tedtoal/SmartVent_Thermostat/README.md

# SmartVent_Thermostat

SmartVent custom thermostat project files

This project is described on hackster.io:

https://www.hackster.io/ted-toal/build-a-beutler-smartvent-custom-thermostat-6fa595
