tedtoal/SmartVent_Thermostat/documents/AZ-Touch_MKR_Rev_B.pdf

# AZ-Touch MKR (mk II)

Top wall enclosure with touchscreen for Arduino MKR & Nano

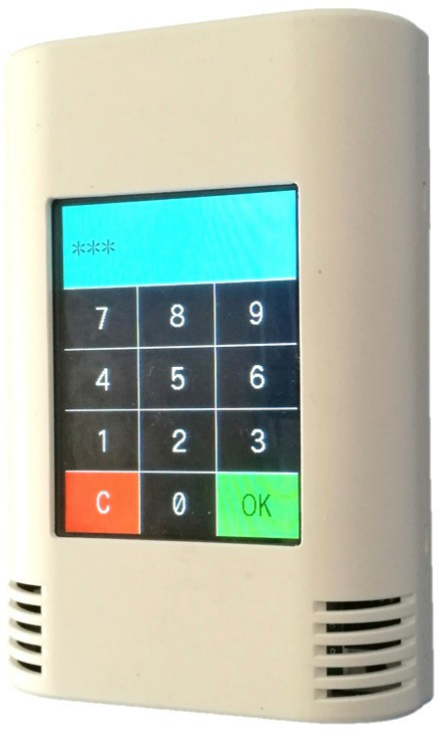
[picture p1: figure]
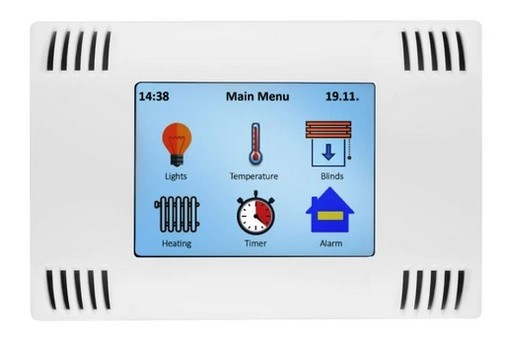
[picture p2: figure]

Features enlosure and pcb:

- top wall mounting enclosure
- 2.8 inch (7,10cm) tft screen with 320 x 240 pixel resolution
- SPI display controller ILI9341
- Resitive touch with SPI touch controller XPT2046
- Integrated 5V/1.7A voltage regulator (Vin 9...35V DC)
- Integrated prototyping area
- 4-pin removable terminal block for prototyping area & power supply
- Marked and connected GPIO & power pins beside the proto area
- Integrated piezo beeper
- Plug-in positions for Arduino MKR or Arduino Nano 33 / BLE / RP2040 boards
- Plug-in position for optional Arduino MKR shield
- Vented cover to allow through air flow
Datasheet AT-Touch MKR Rev B | Page 1 of 5 | 10/2021

Features voltage regulator:

- | Input voltage: | 15 – 30V DC
- Output voltage: 5V / 1.4A DC

Enclosure:
- Outside dimensions: 120mm x 80mm x 35mm (W x H x D)
- | Breadboard area: | 43mm x 39mm (W x H)
- | Material: | ABS
- | Finish top shell: | white
- | Finish bottom shell: | white
Datasheet AZ-Touch MKR Rev B | Page 2 of 5 | 10/2021

Top wall enclosure with touchscreen for Arduino MKR & Nano

Applications :
- Home automation
- Door access and door control
- HVAC applications
- Internet of Things (IoT)
- Intelligent wireless light switch
- Monitoring of sensor data
- Metering
- Intruder alarm systems

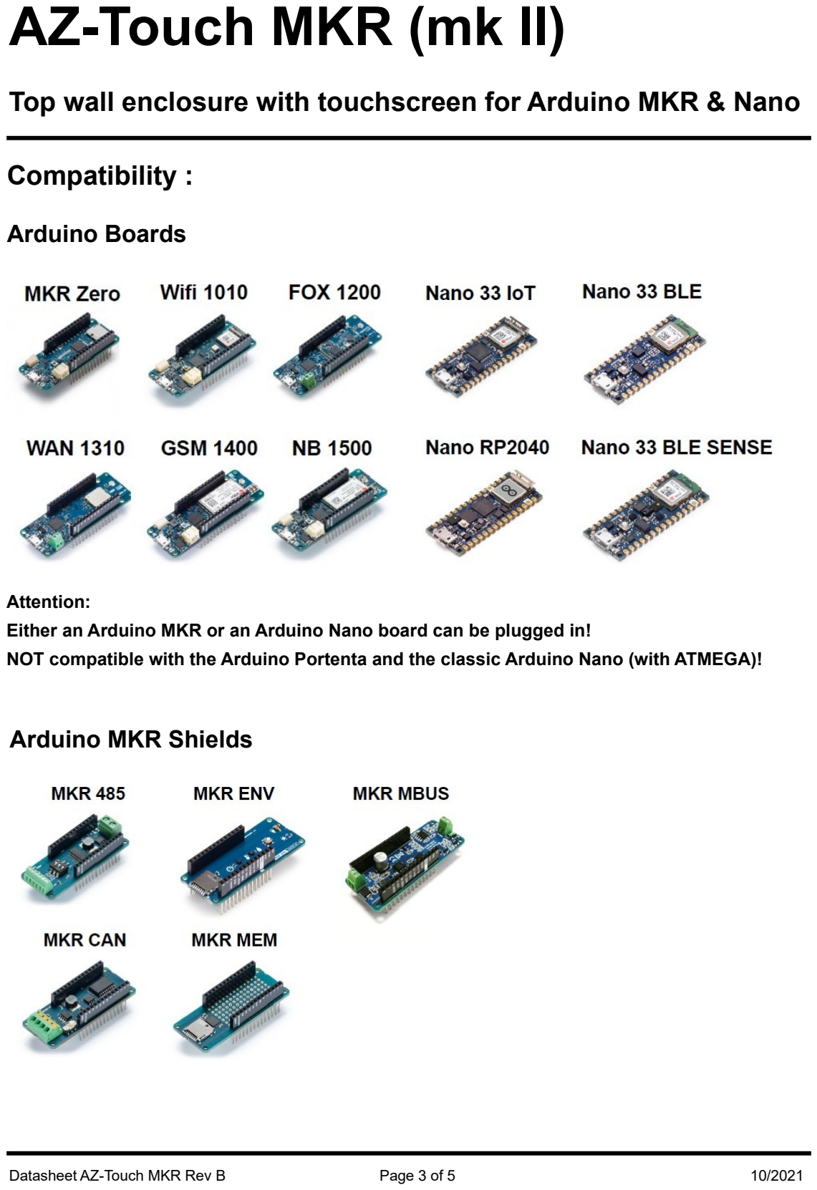
[picture p3: page 3]

Datasheet AZ-Touch MKR Rev B | Page 3 of 5 | 10/2021

Top wall enclosure with touchscreen for Arduino MKR & Nano

Compatibility :

Arduino Boards

Arduino MKR Shields

Attention:
Either an Arduino MKR or an Arduino Nano board can be plugged in!
NOT compatible with the Arduino Portenta and the classic Arduino Nano (with ATMEGA)!

Part-No. | Version | Features
ARTHME | DIY Kit | - diy kit version - pre-assembled pcb (SMT parts only) - THT parts - 2.8 inch (7,10 cm) touchscreen - milled enclosure
ARTHMA | Finished device | - pre-assembled and tested device

Part number table:

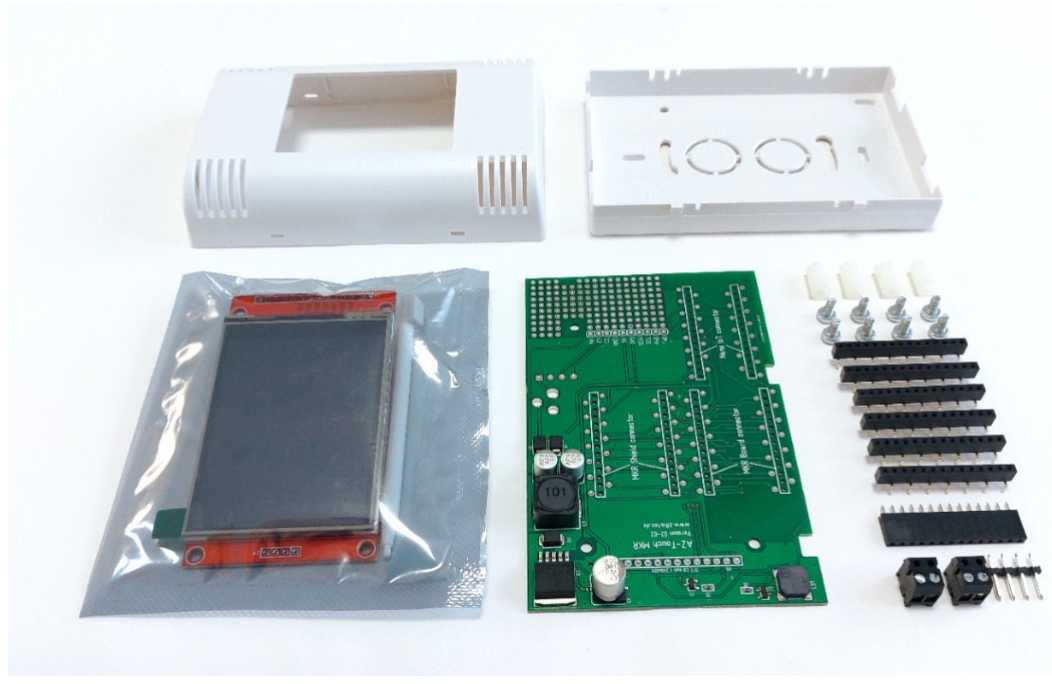
[picture p4: figure]

Datasheet AZ-Touch MOD Rev B | Page 4 of 5 | 11/2020

Top wall enclosure with touchscreen for Arduino MKR & Nano

ARTHME
(diy kit version)

ARTHMA
(assembled device)

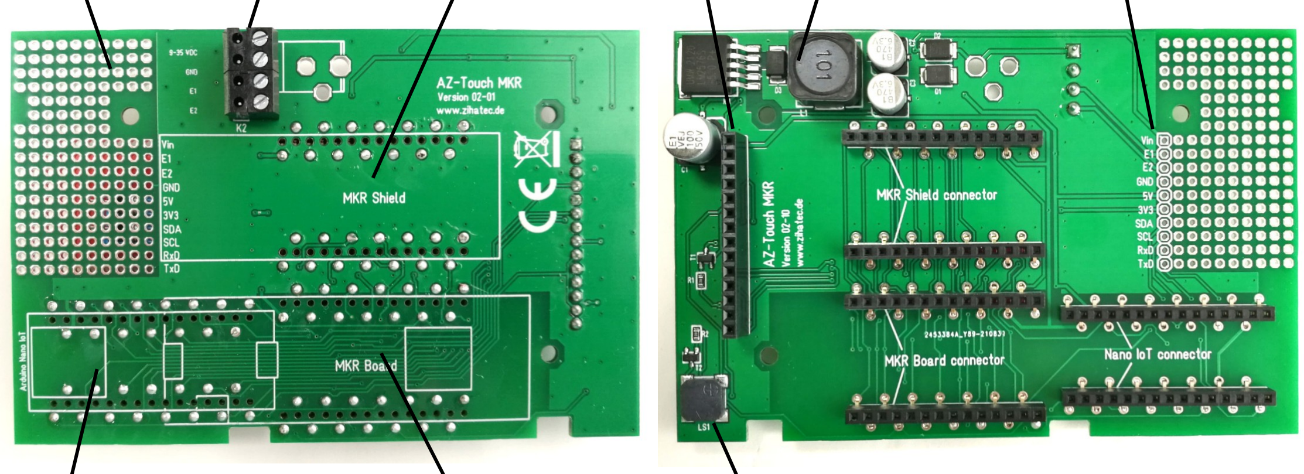
[picture p5: figure]

- Terminal for power supply & proto board
- Plug-in slot for Arduino MKR board
- Plug-in slot for Arduino Nano board
- Plug-in slot for Arduino MKR shield
- Voltage regulator (9..35V Vin / 5V Vout)
- Piezo beeper
- Breadboard / proto board area
- GPIO pins for proto board
- Header for touch screen

Features main board:

Datasheet AZ-Touch MKR Rev B | Page 5 of 5 | 10/2021

Top wall enclosure with touchscreen for Arduino MKR & Nano

3

Back side | Front side

1

2

4 | 9 | 5 | 8

6

7
