tedtoal/SmartVent_Thermostat/documents/SmartVent Thermostat Schematic V4.pdf

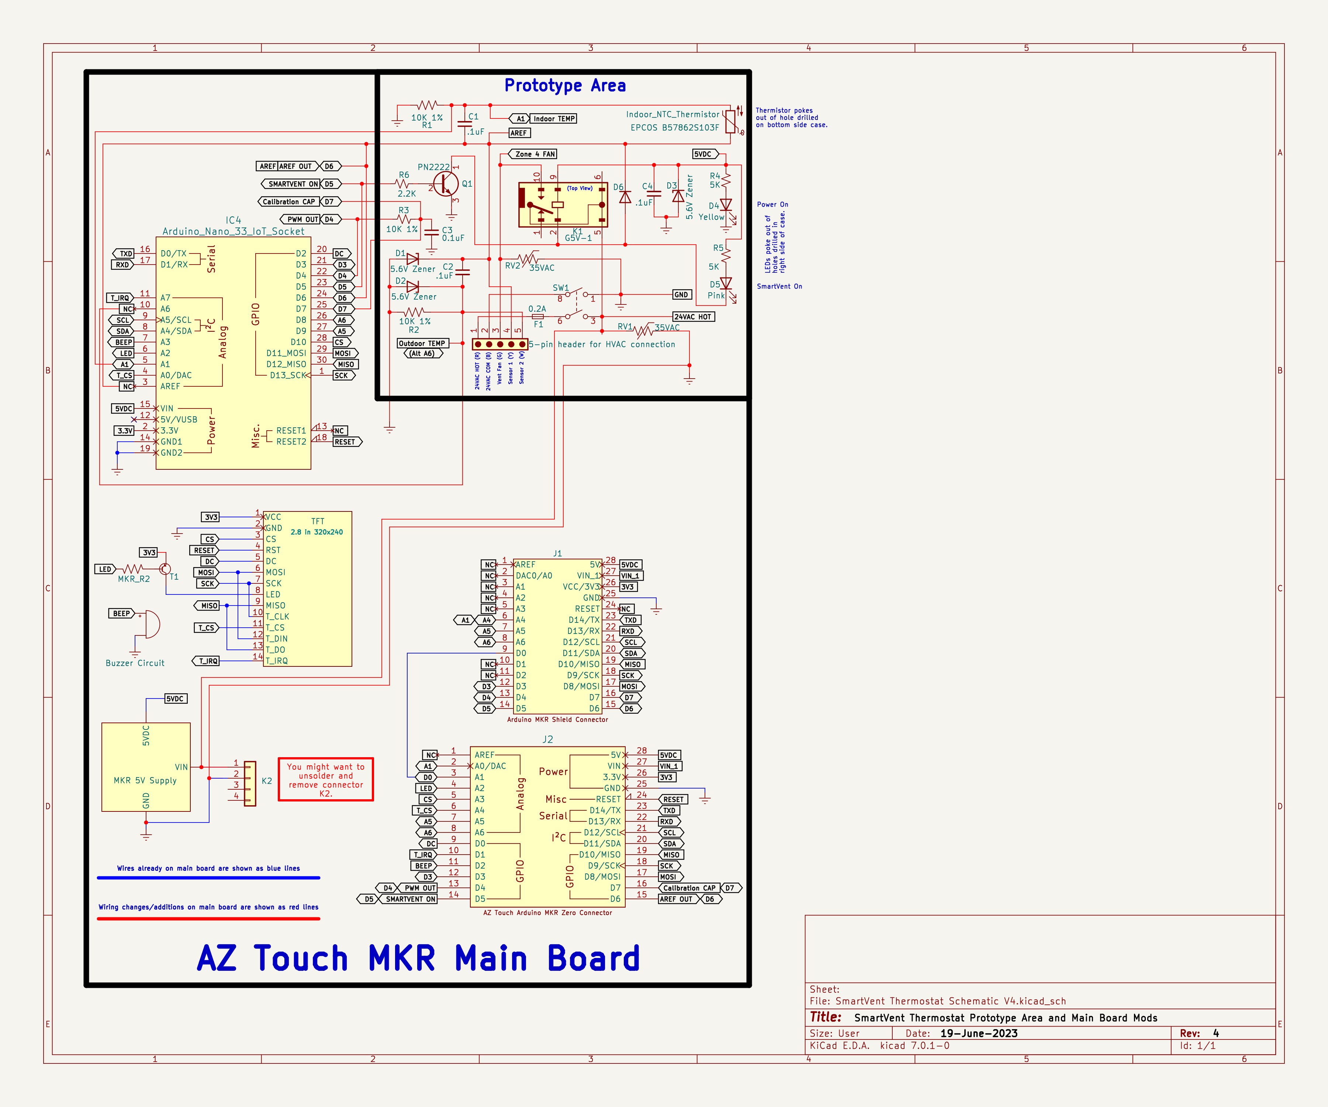
[picture p6: page 1]
