tedtoal/SmartVent_Thermostat/documents/Thermistors/Thermistor_NTC503K.pdf

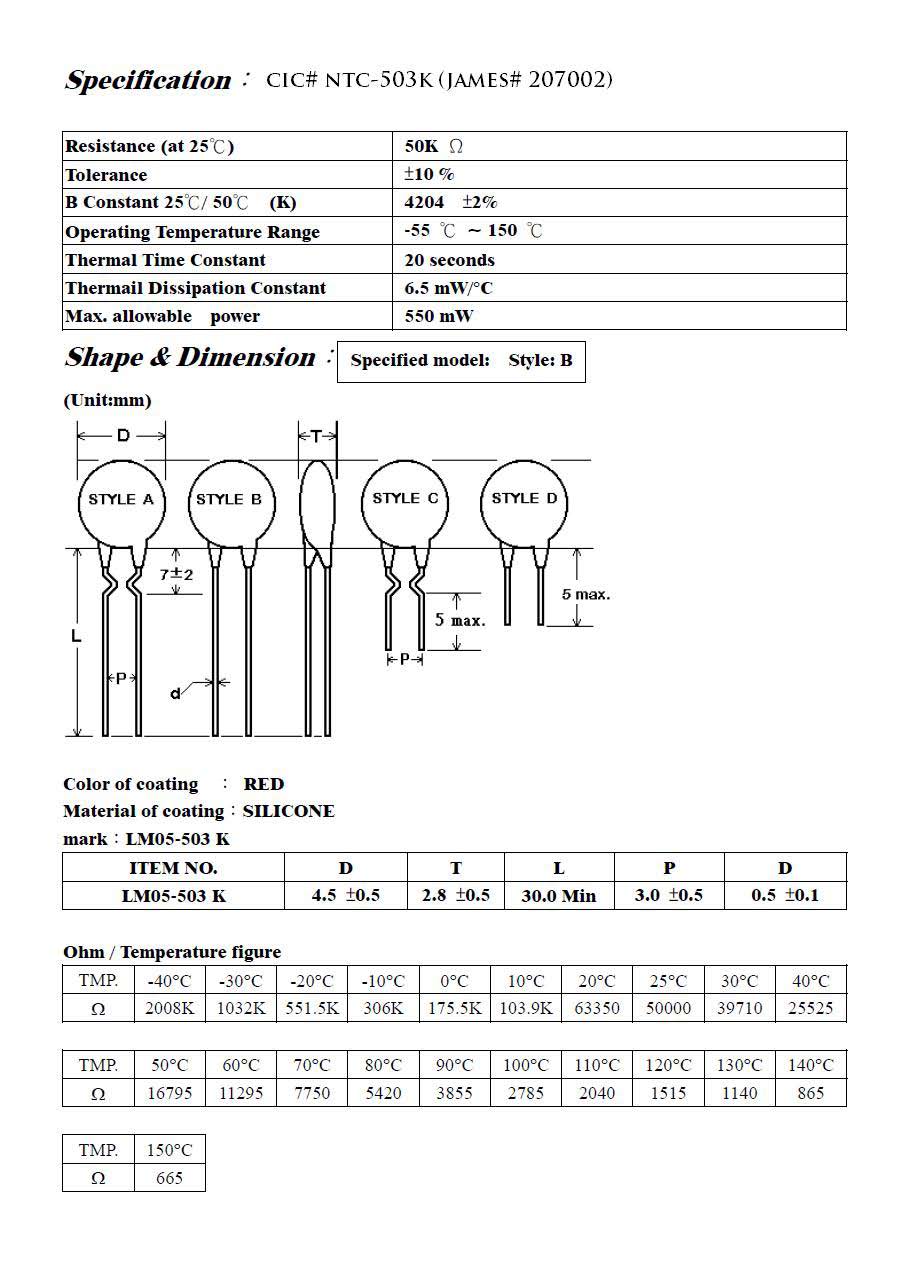
[picture p7: page 1]
