tedtoal/SmartVent_Thermostat/documents/AZ-Touch_MKR_rev_B_Assembly_Instruction.pdf

Construction manual AZ-Touch MKR Rev B

# AZ-Touch MKR

## Rev B

## construction manual

Rev. | Date | Description
A | 2019-03-19 | First Release
B | 2021-09-16 | Adaption to Version 02-xx

## Tools:

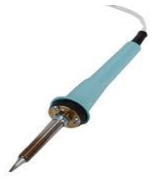
[picture p20: figure]

## a regulated soldering iron (25..40W) with small tip

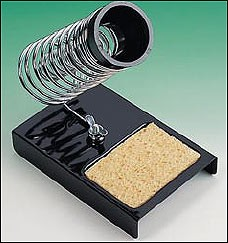
[picture p21: figure]

## a wet sponge to clean the tip

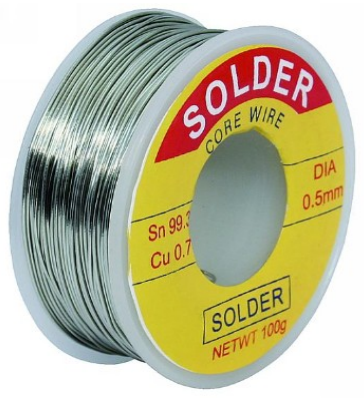
[picture p22: figure]

## thin solder wire

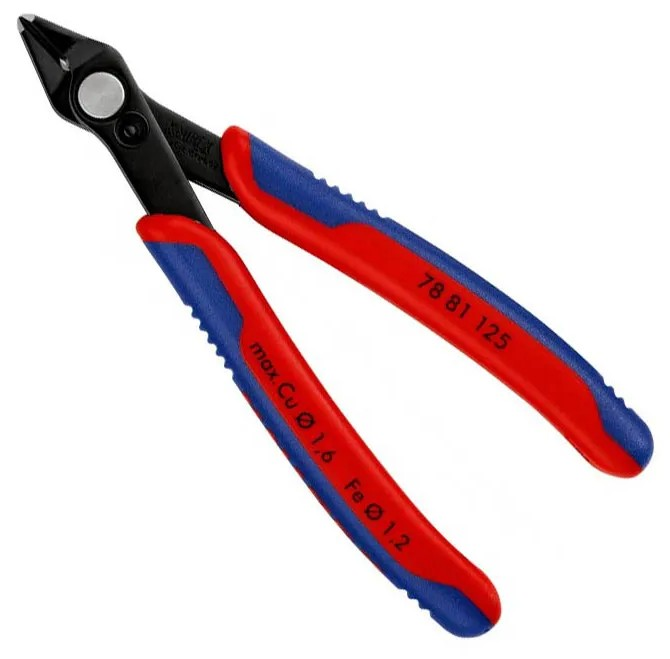
[picture p23: figure]

## Side cutting pliers

## Needle nose pliers

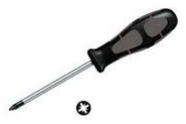
[picture p24: figure]

## Medium cross slot screwdriver

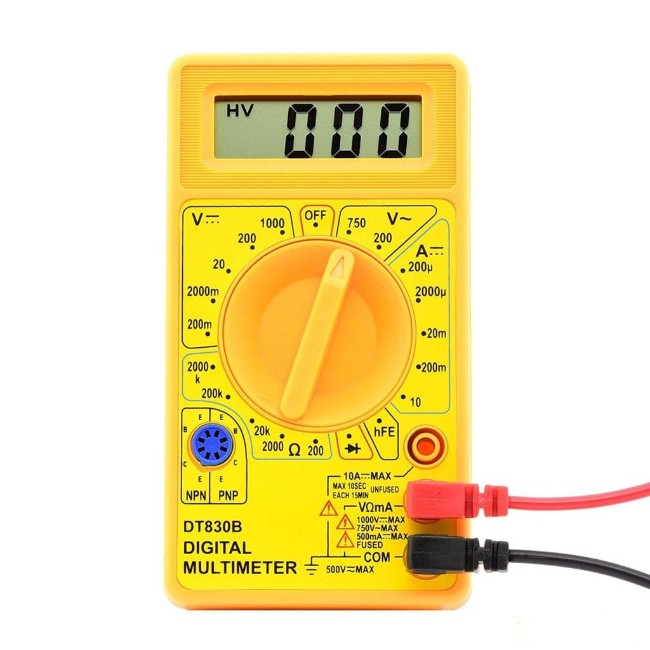
[picture p25: figure]

## Optional multimeter

## Part list:

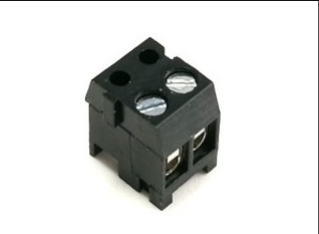
[picture p26: figure]
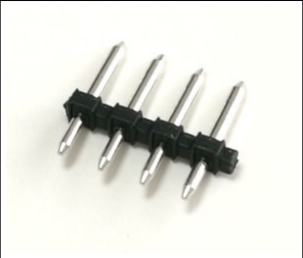
[picture p27: figure]
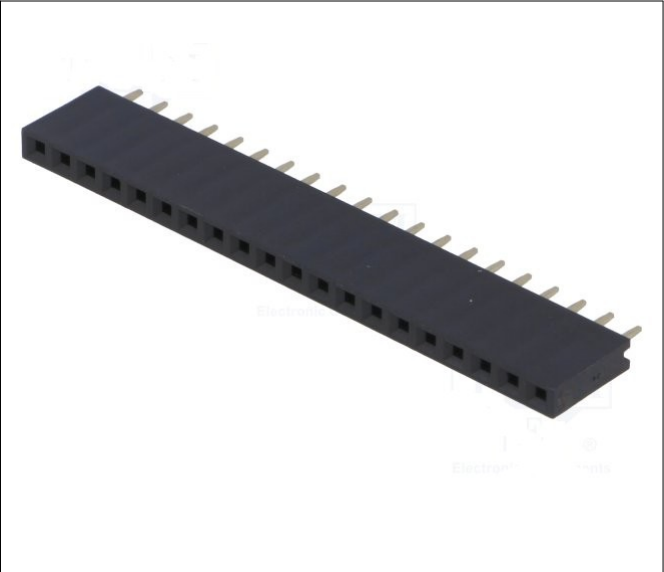
[picture p28: figure]

2x 2pole terminal block (K2) | 1x 4pole terminal header (K2) | 1x 14pole female header (K5)

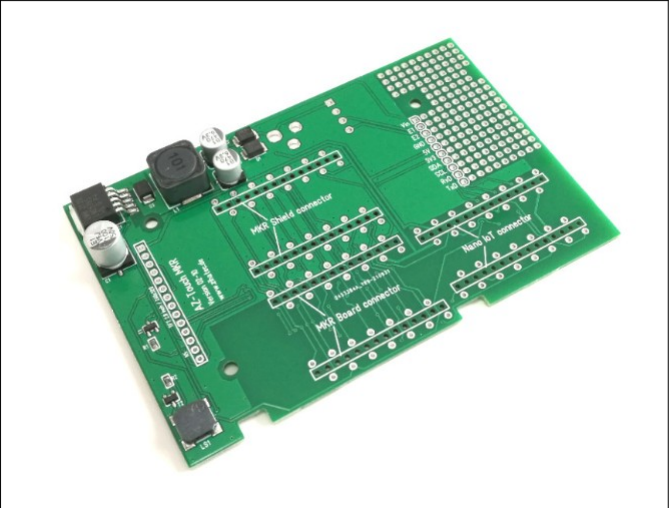
[picture p29: figure]
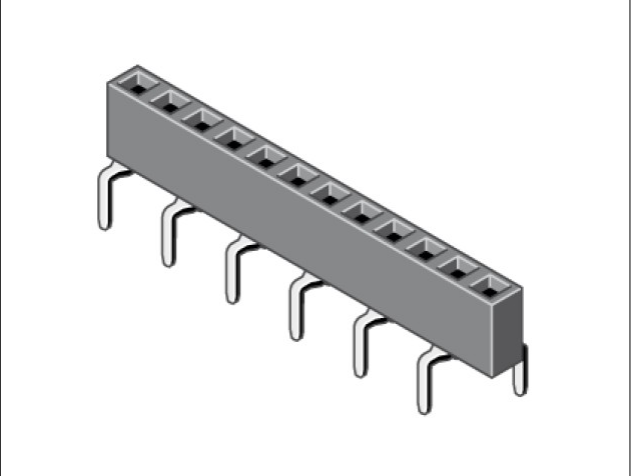
[picture p30: figure]
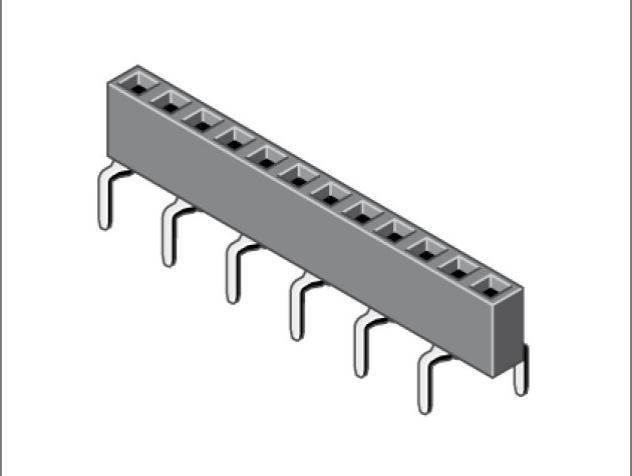
[picture p31: figure]

4x 14pole centipede female header | 2x 15pole centipede female header | 1x Pre-assembled pcb

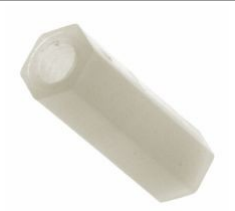
[picture p32: figure]
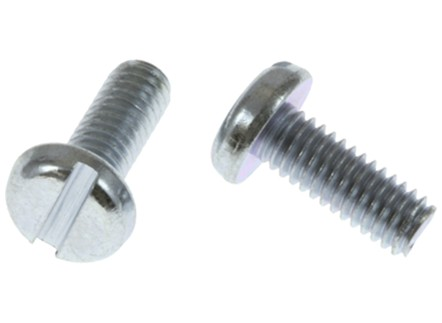
[picture p33: figure]

7x Screw M3 4mm | 4x Spacer M3 11mm

## 1.) Place and solder the centipede headers

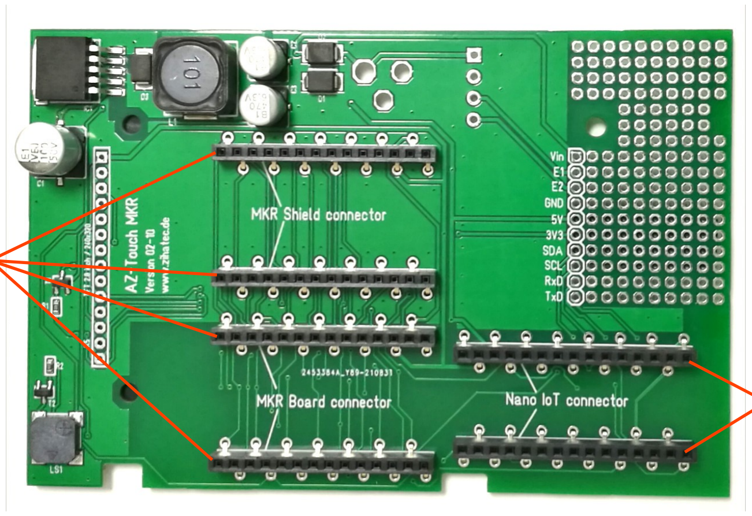
[picture p34: figure]

It is recommended to shorten the pins on the back flat with a wire cutter before soldering the connectors:

15pole
headers

14pole
headers

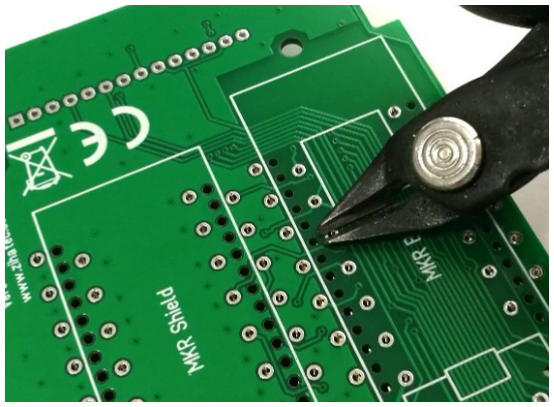
[picture p35: figure]
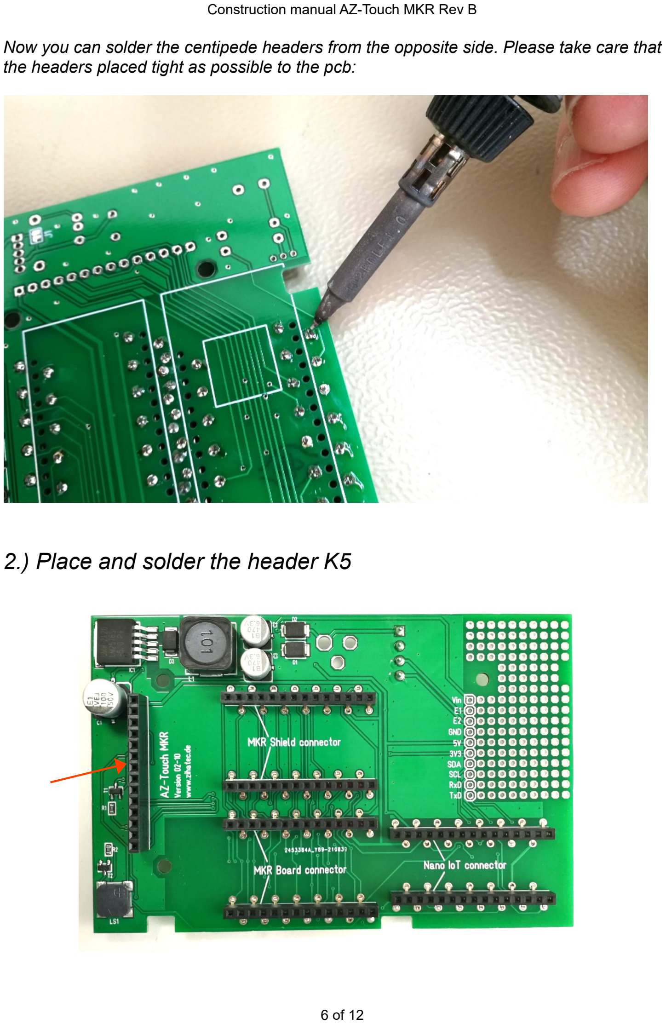
[picture p36: page 6]

Now you can solder the centipede headers from the opposite side. Please take care that the headers placed tight as possible to the pcb:

## 2.) Place and solder the header K5

## 3.) Place and solder the header K2

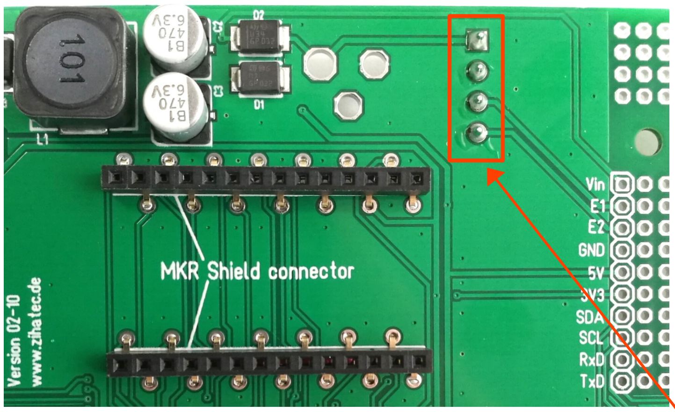
[picture p37: figure]

Attention!
K2 is placed on the
pcb backside

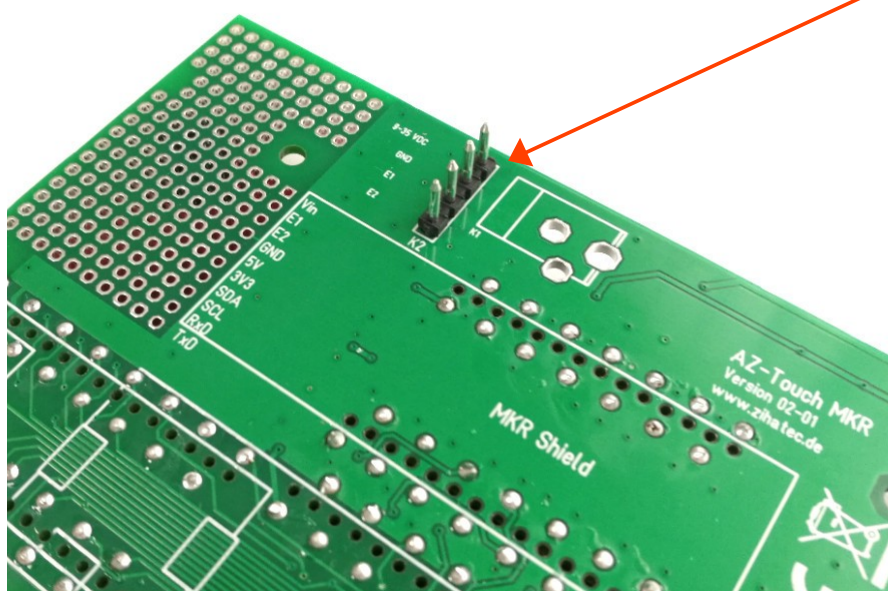
[picture p38: figure]

## 4.) Prepare the terminal blocks

Find the 3.5mm terminal blocks, they're brown and come in 2-pin shapes. You'll need to slide two 2-pin blocks together:

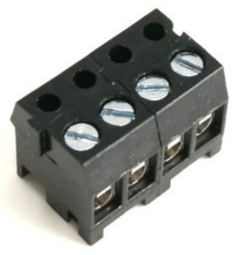
[picture p39: figure]

Now you can plug the terminal block onto the pin header:

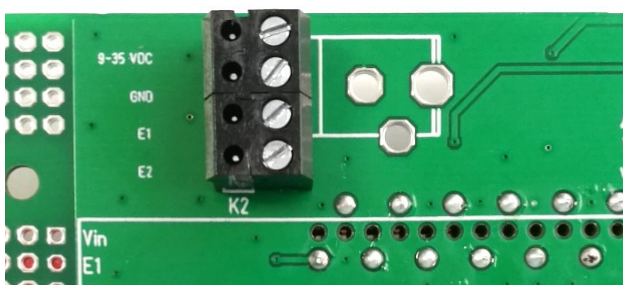
[picture p40: figure]

## 5.) Check the power supply

Its time to check the function of the power supply before the final assembly of the unit.

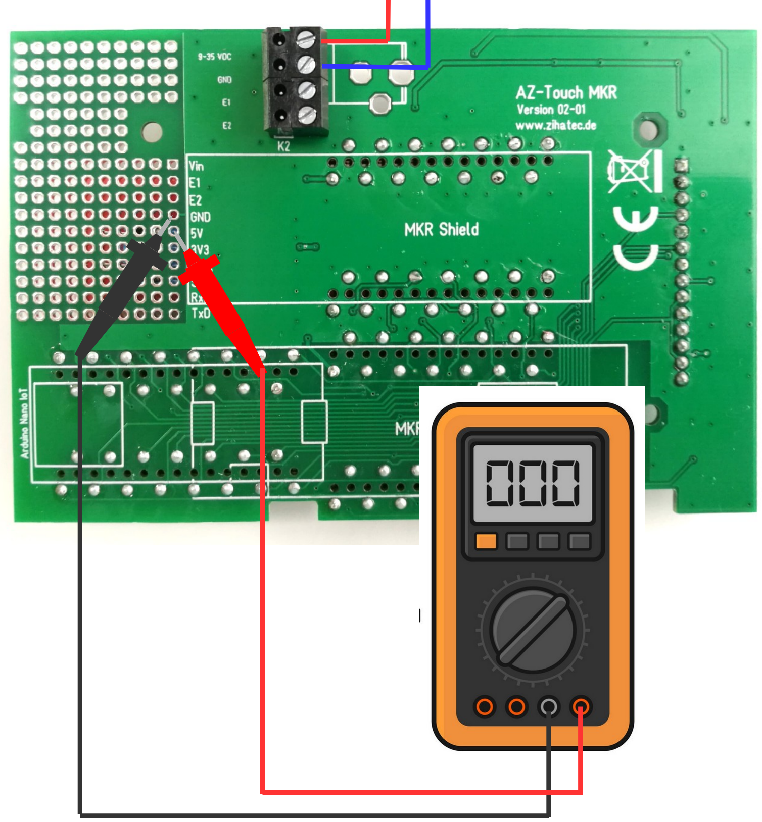
[picture p41: figure]

## You have to measure a voltage between 4.9 – 5.1V!

Vin
9 – 35V DC
+ -

## 6.) Mounting of Spacers

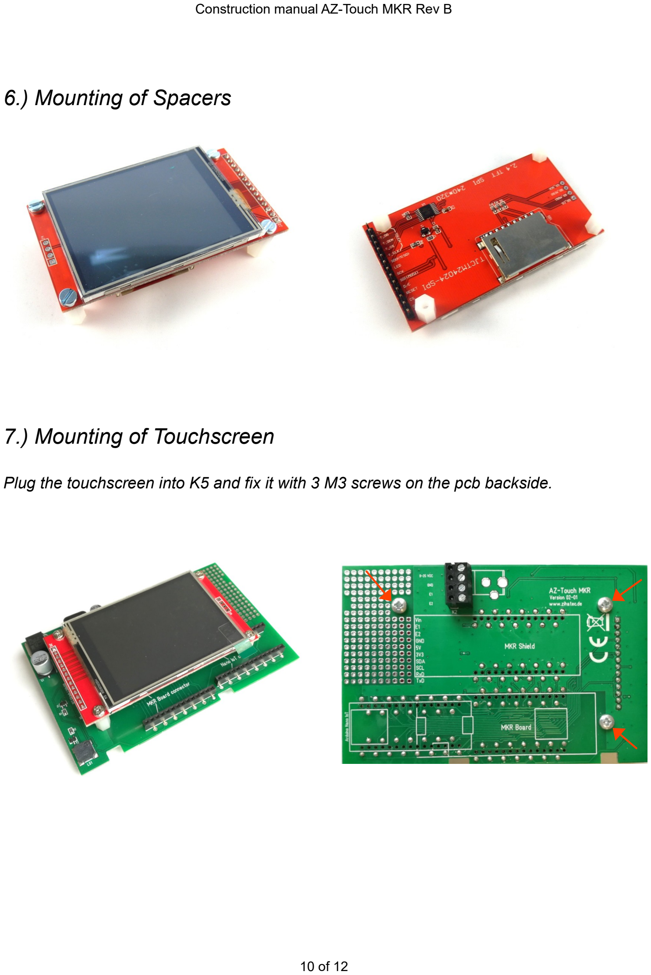
[picture p42: page 10]

## 7.) Mounting of Touchscreen

Plug the touchscreen into K5 and fix it with 3 M3 screws on the pcb backside.

## 8.) Mounting of pcb in the top shell

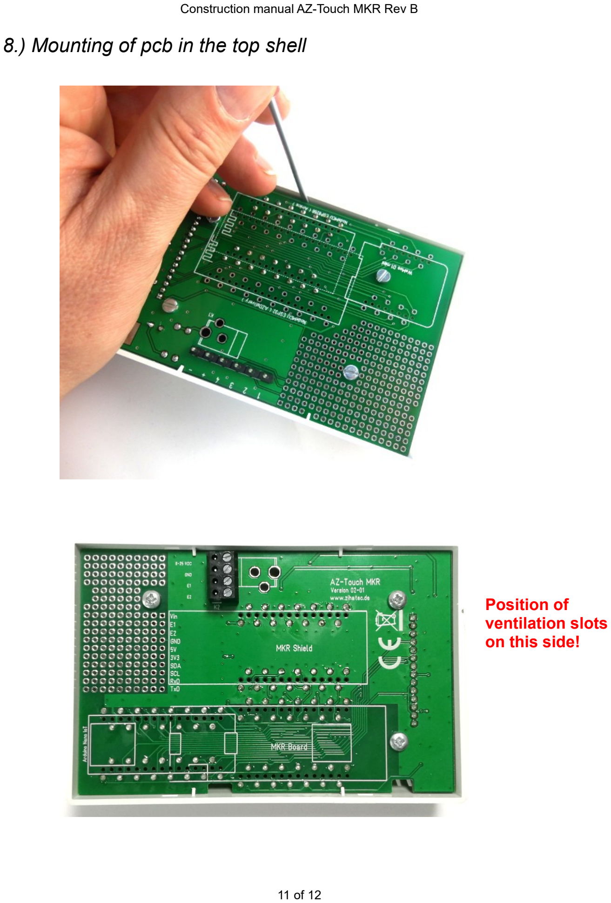
[picture p43: page 11]

Position of
ventilation slots
on this side!

## 9.) Mounting of Arduino Boards and Shields

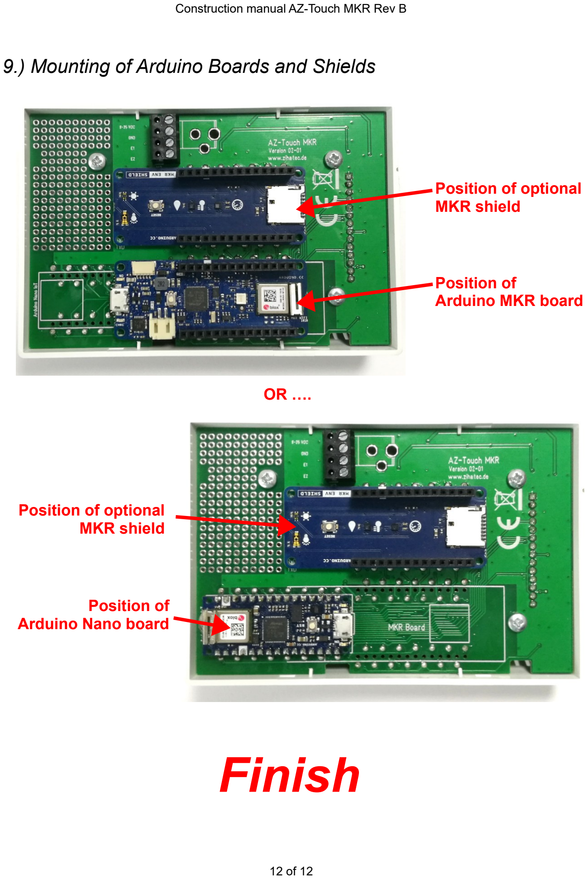
[picture p44: page 12]

# Finish

Position of
Arduino MKR board

Position of optional
MKR shield

OR ….

Position of optional
MKR shield

Position of
Arduino Nano board
