tedtoal/SmartVent_Thermostat/documents/AZ-Touch_MKR_schematic_V02-02.pdf

## Vin_1

D0 A4 | D7 D6 D5 D4 D3 +5V | GND

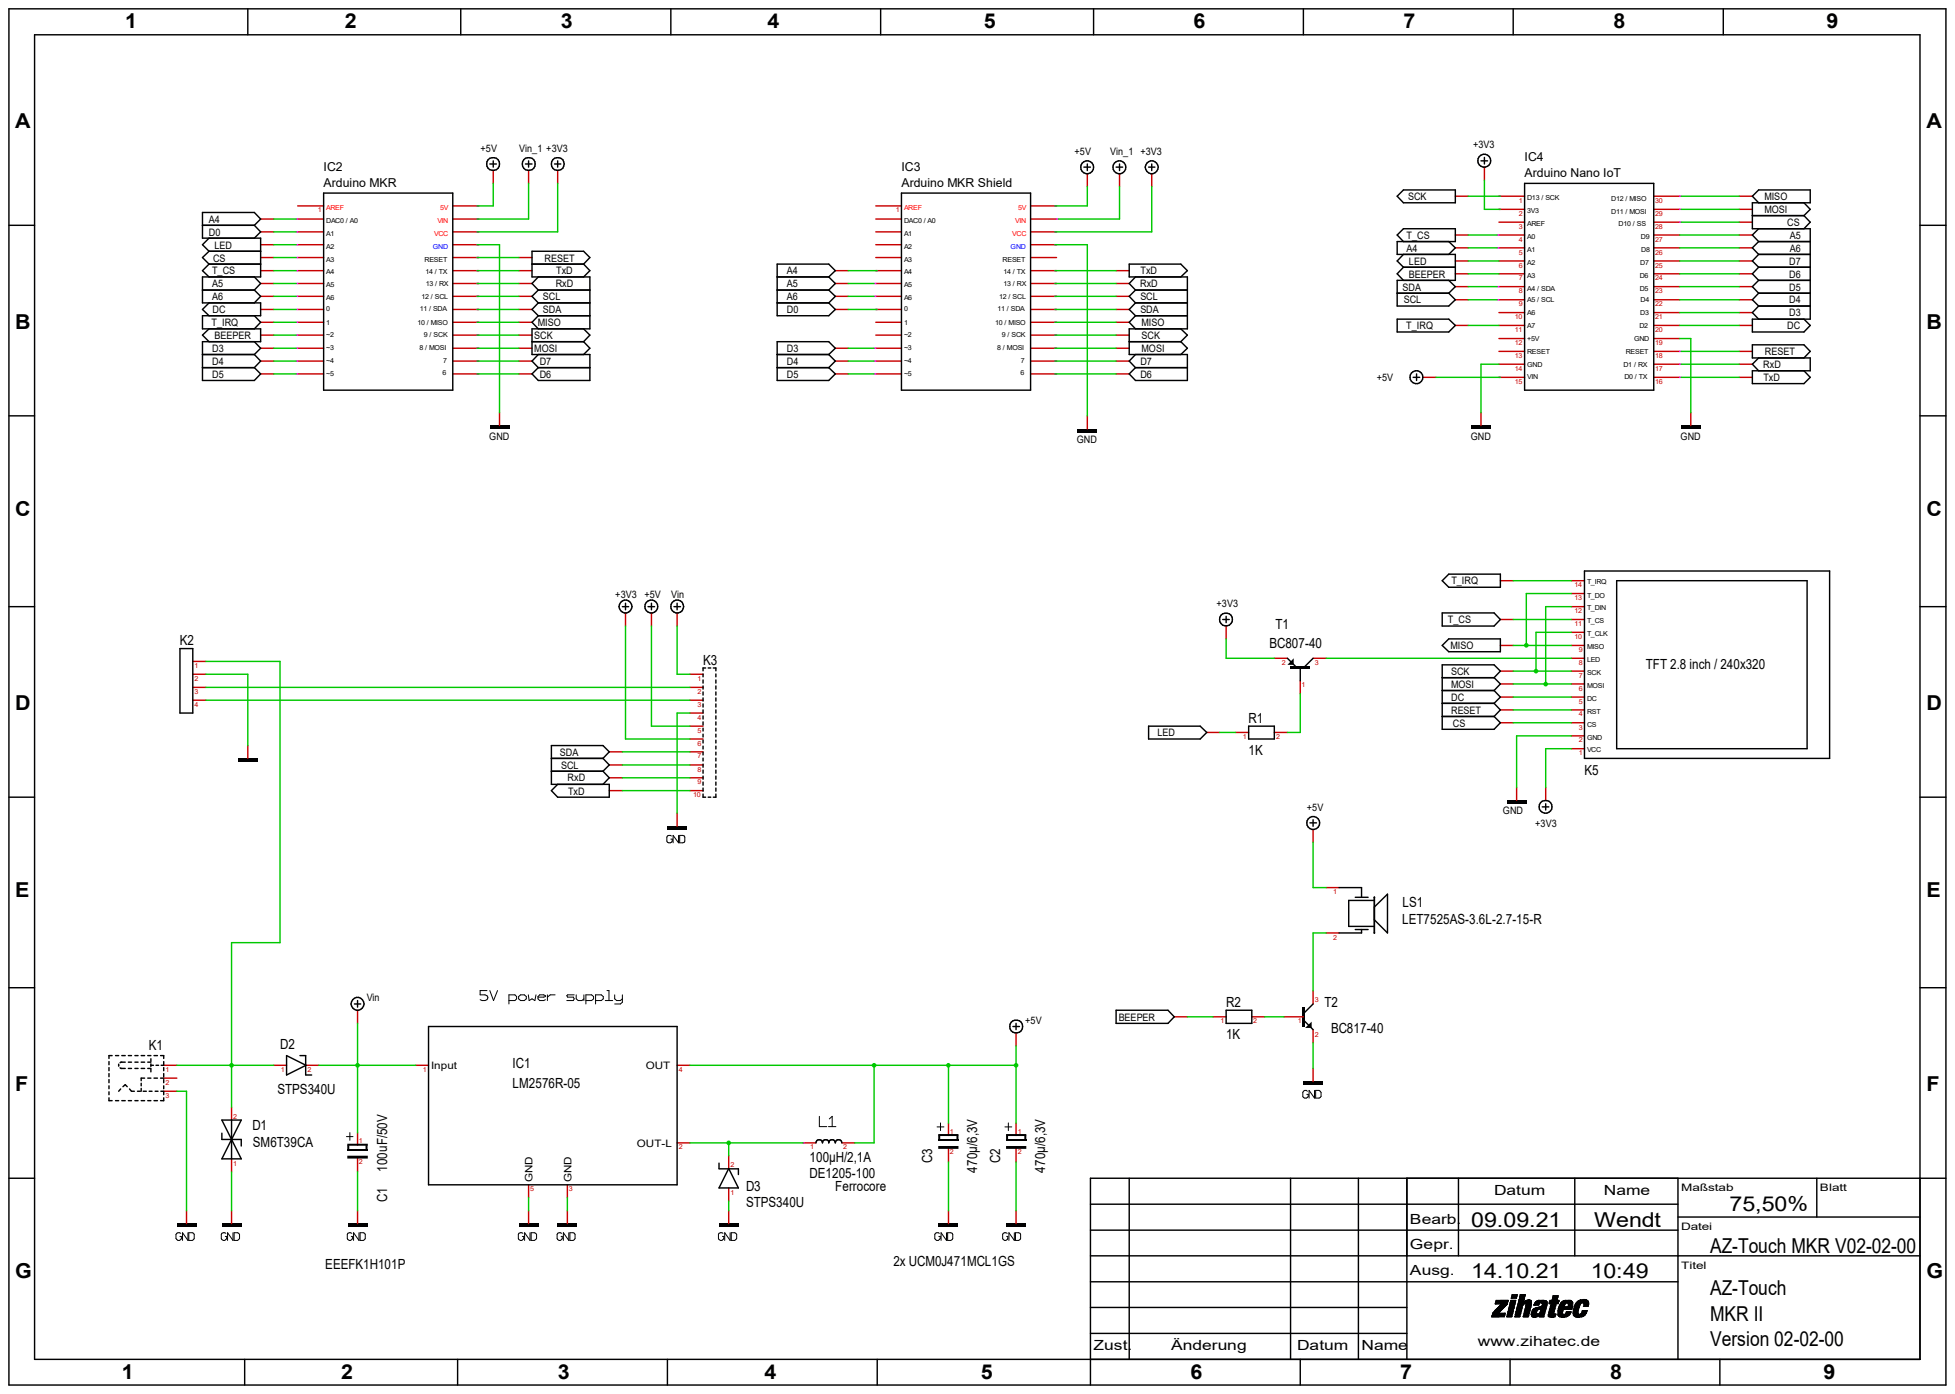
[picture p45: page 1]
