tedtoal/SmartVent_Thermostat/documents/Arduino-Nano-33-IoT-Schematic.pdf

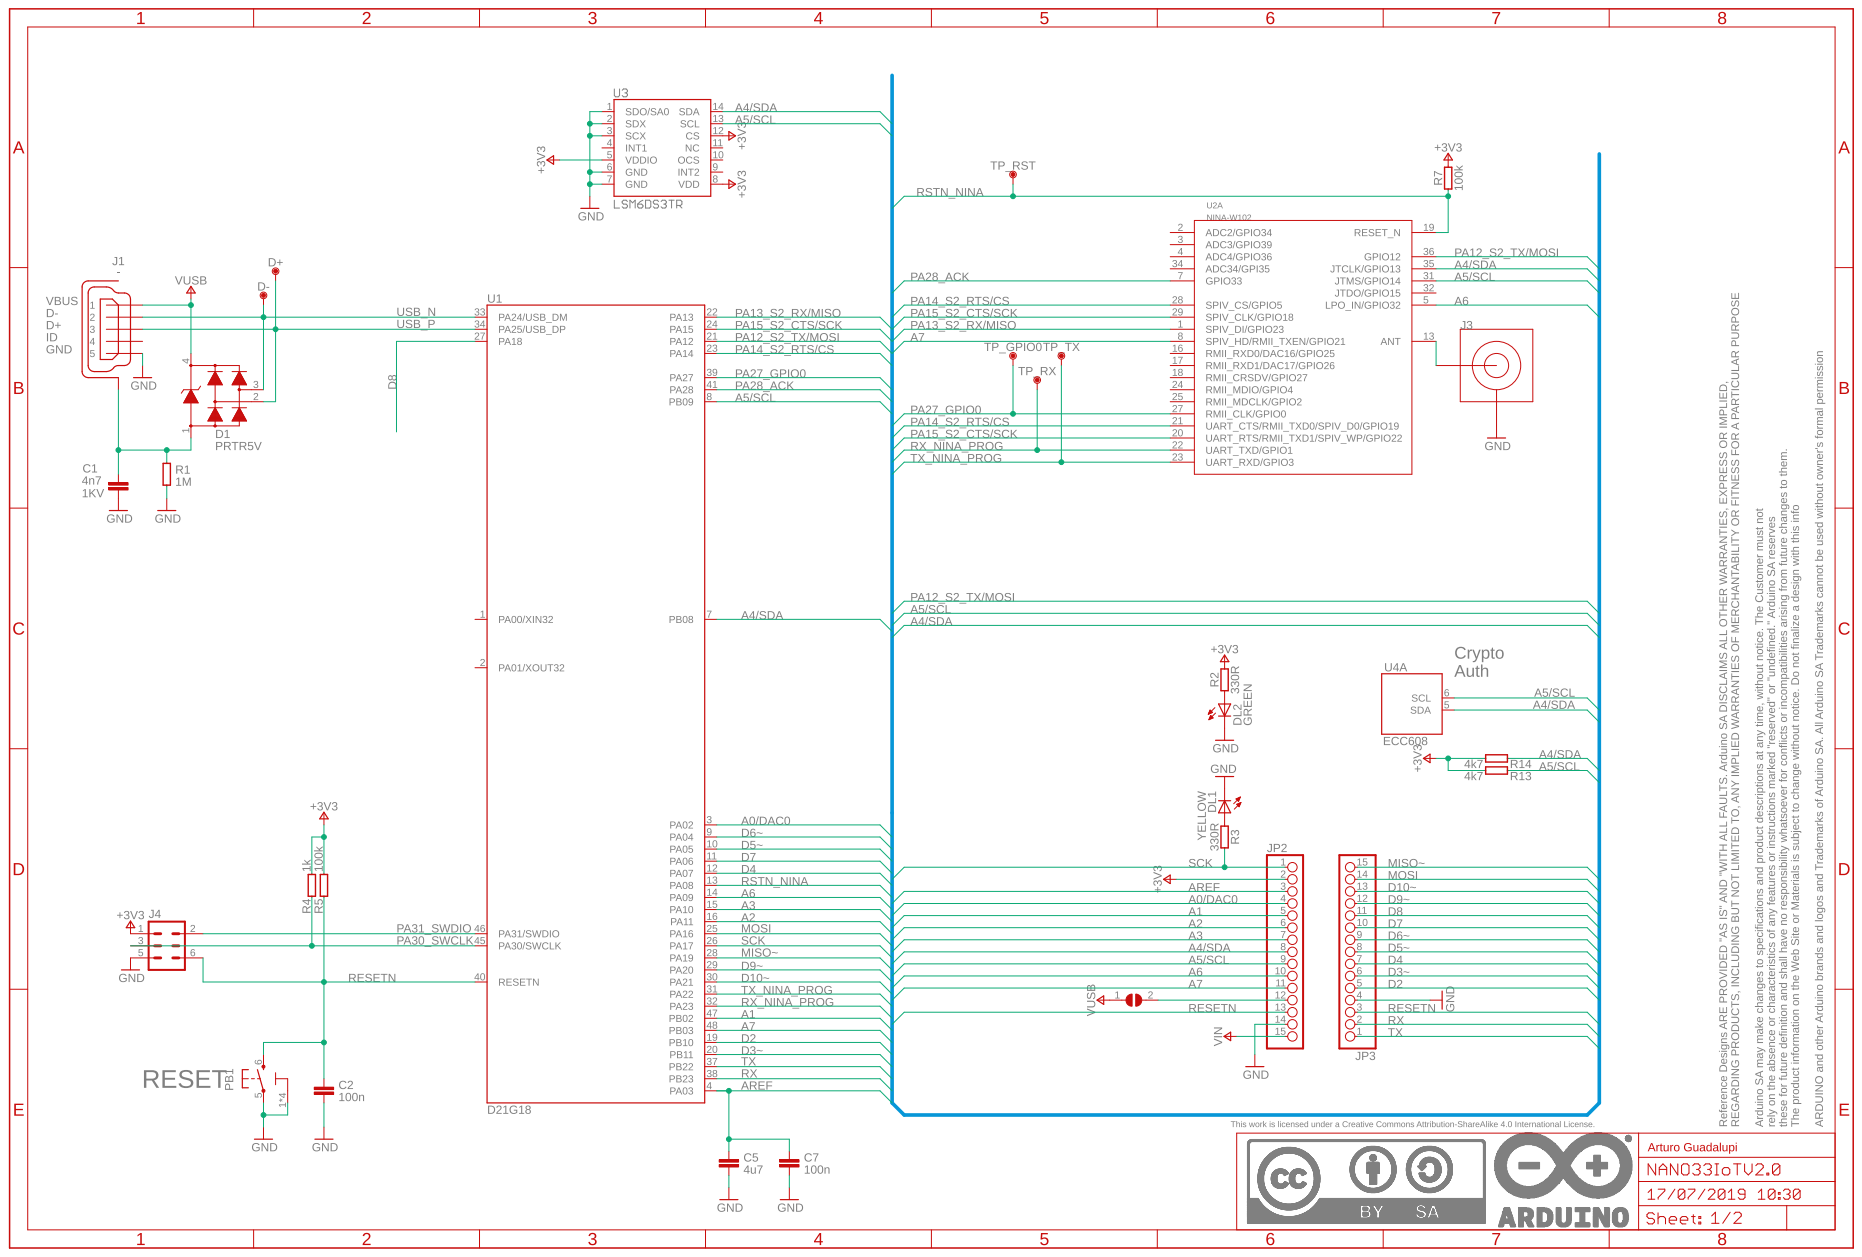
[picture p46: page 1]

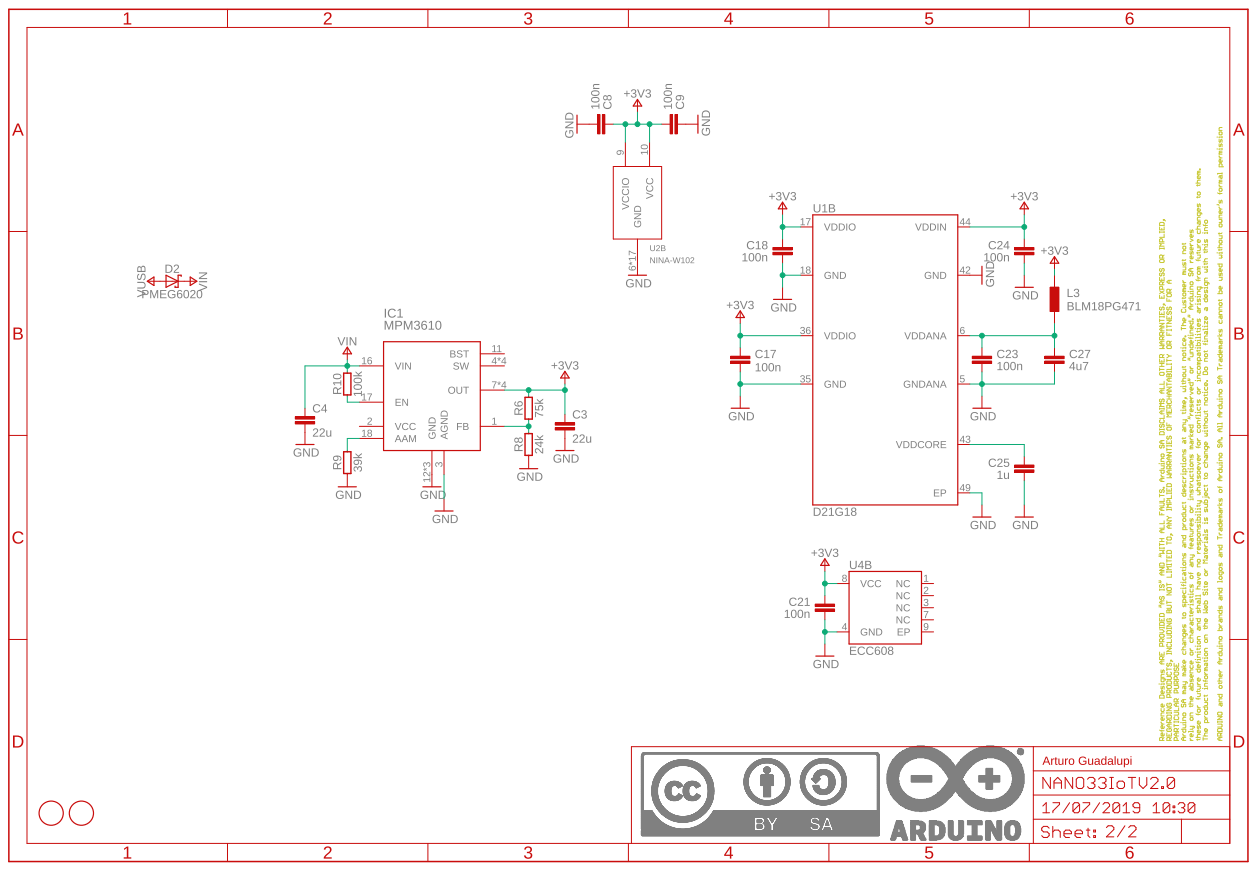
[picture p47: page 2]
