tedtoal/SmartVent_Thermostat/documents/Thermistors/Thermistor_NTC_10k_3435.pdf

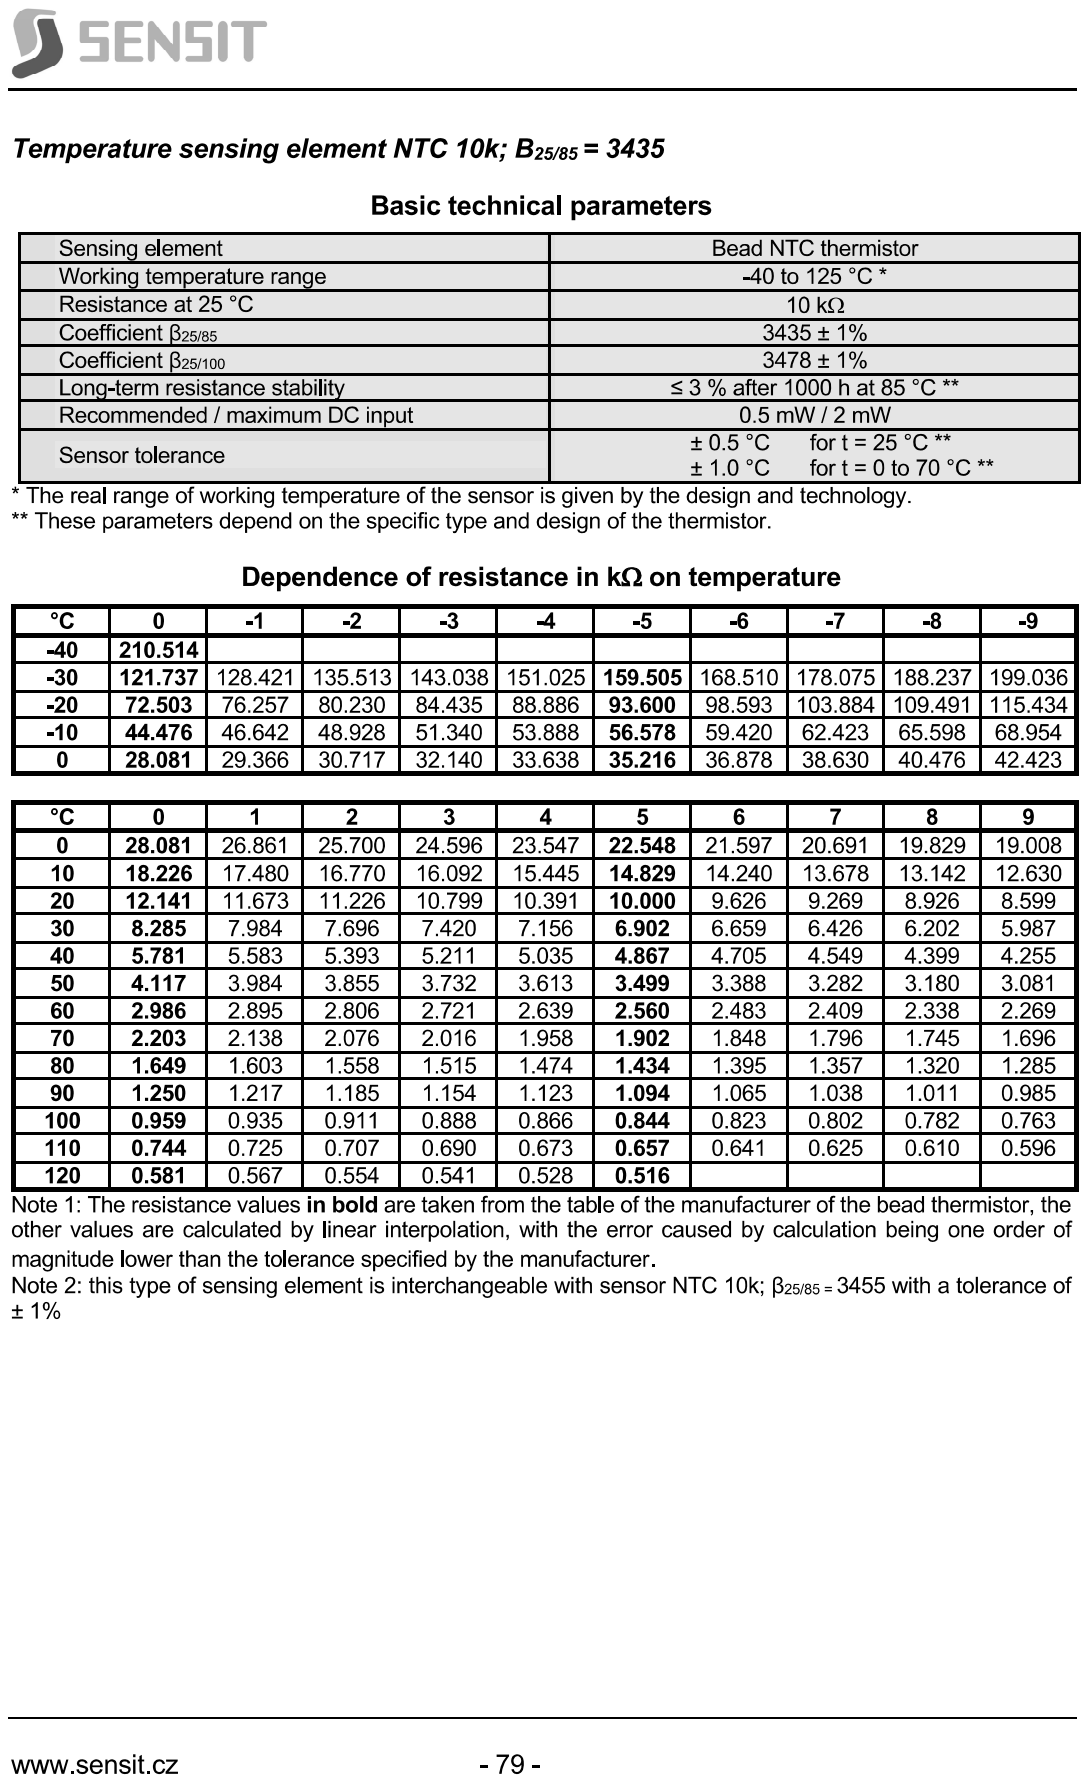
[picture p48: page 1]
