tedtoal/SmartVent_Thermostat/documents/SmartVent Thermostat Schematic V4/SmartVent Thermostat Schematic V4.kicad_pcb

## KiCad design Hardware/esp32-c3-joystick/esp32-c3-joystick.kicad_sch

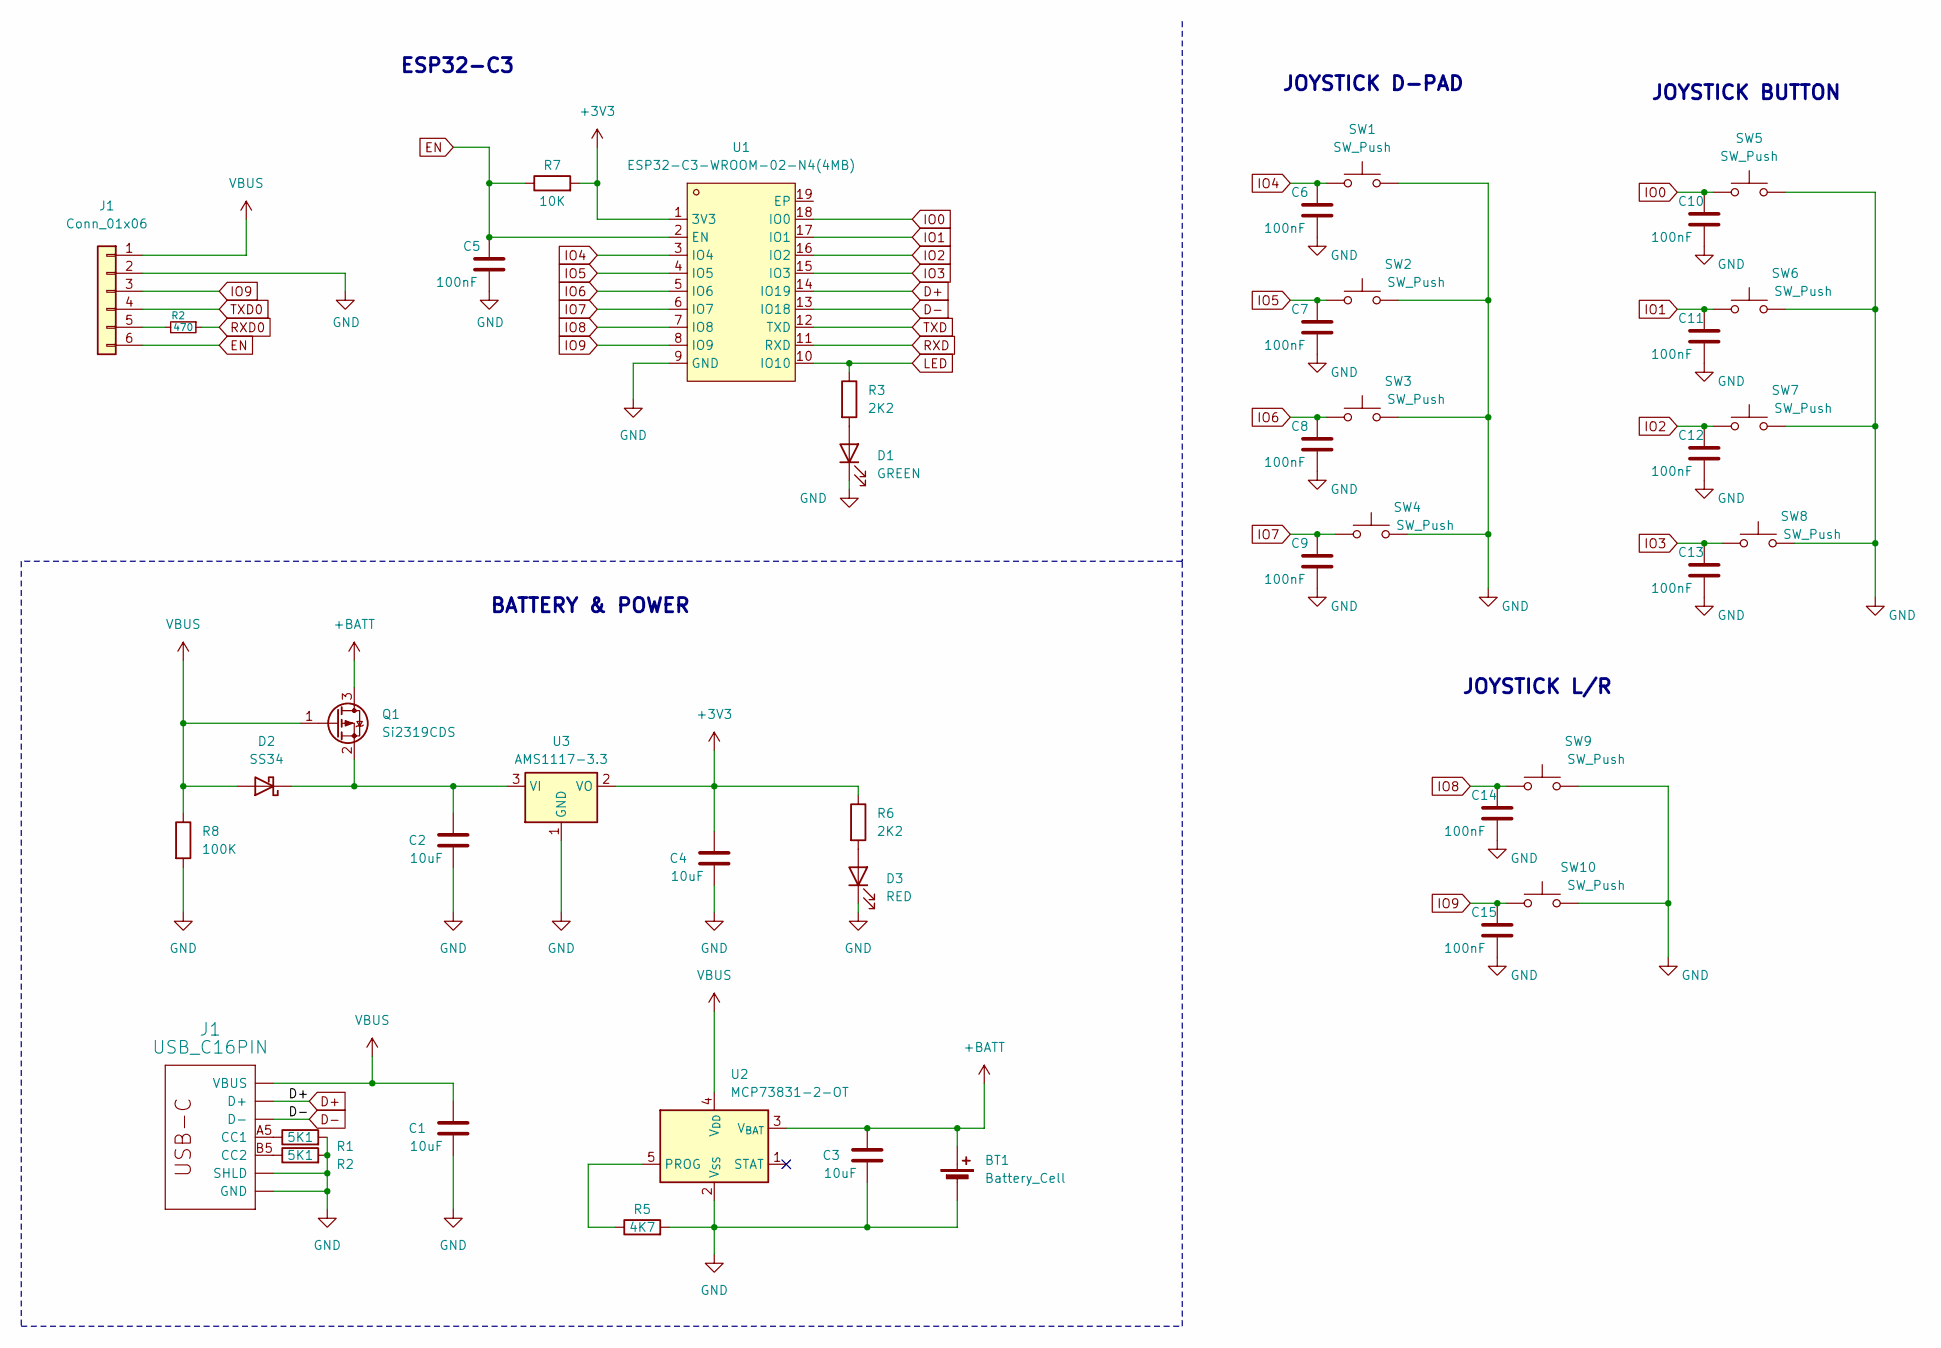
[picture p49: schematic esp32-c3-joystick.kicad_sch]

Parts:
BT1: Battery_Cell
C1, C2, C3, C4: 10uF; C_0603_1608Metric
C5, C6, C7, C8, C9, C10, C11, C12, C13, C14, C15: 100nF
D1: GREEN; LED_0805_2012Metric
D2: SS34; D_SMA
D3: RED; LED_0805_2012Metric
J1: USB_C16PIN; USB-C-COM-15111
Q1: Si2319CDS; SOT-23
R1: 5K1; R_0603_1608Metric
R2: 470; R_0805_2012Metric_Pad1.20x1.40mm_HandSolder
R3, R6: 2K2; R_0603_1608Metric
R5: 4K7; R_0603_1608Metric
R7: 10K
R8: 100K; R_0603_1608Metric
SW1, SW2, SW3, SW4, SW5, SW6, SW7, SW8, SW9, SW10: SW_Push
U1: ESP32-C3-WROOM-02-N4(4MB); BULETM-SMD_ESPRESSIF_ESP32-C3-WROOM-02-N4-4MB; LCSC Part C2934560
U2: MCP73831-2-OT; SOT-23-5
U3: AMS1117-3.3; SOT-223-3_TabPin2

Connections:
+3V3: C4.2, R6.1, R7.2, U1.1 (3V3), U3.2 (VO)
+BATT: BT1.1 (+), C3.2, Q1.3 (D), U2.3 (V_{BAT})
D+: J1.A6 (D+), J1.B6 (D+), U1.14 (IO19)
D-: J1.A7 (D-), J1.B7 (D-), U1.13 (IO18)
EN: C5.1, J1.6, R7.1, U1.2 (EN)
GND: BT1.2 (-), C1.1, C2.1, C3.1, C4.1, C5.2, C6.2, C7.2, C8.2, C9.2, C10.2, C11.2, C12.2, C13.2, C14.2, C15.2, D1.1 (K), D3.1 (K), J1.2, J1.GND, J1.GND2 (GND), J1.SHLD1 (SHLD), J1.SHLD2 (SHLD), J1.SHLD3 (SHLD), J1.SHLD4 (SHLD), J1.SHLD5 (SHLD), J1.SHLD6 (SHLD), J1.SHLD7 (SHLD), J1.SHLD8 (SHLD), R1.2, R2.2, R5.2, R8.2, SW1.2, SW2.2, SW3.2, SW4.2, SW5.2, SW6.2, SW7.2, SW8.2, SW9.2, SW10.2, U1.9 (GND), U2.2 (V_{SS}), U3.1 (GND)
IO0: C10.1, SW5.1, U1.18 (IO0)
IO1: C11.1, SW6.1, U1.17 (IO1)
IO2: C12.1, SW7.1, U1.16 (IO2)
IO3: C13.1, SW8.1, U1.15 (IO3)
IO4: C6.1, SW1.1, U1.3 (IO4)
IO5: C7.1, SW2.1, U1.4 (IO5)
IO6: C8.1, SW3.1, U1.5 (IO6)
IO7: C9.1, SW4.1, U1.6 (IO7)
IO8: C14.1, SW9.1, U1.7 (IO8)
IO9: C15.1, J1.3, SW10.1, U1.8 (IO9)
LED: R3.1, U1.10 (IO10)
unnamed: C2.2, D2.1 (K), Q1.2 (S), U3.3 (VI)
unnamed: D1.2 (A), R3.2
unnamed: D3.2 (A), R6.2
unnamed: J1.5, R2.2
unnamed: J1.A5 (CC1), R1.1
unnamed: J1.B5 (CC2), R2.1
unnamed: R5.1, U2.5 (PROG)
RXD: U1.11 (RXD)
RXD0: R2.1
TXD: U1.12 (TXD)
TXD0: J1.4
VBUS: C1.2, D2.2 (A), J1.1, J1.VBUS1 (VBUS), J1.VBUS2 (VBUS), Q1.1 (G), R8.1, U2.4 (V_{DD})

Notes on the sheet:
JOYSTICK L/R
BATTERY & POWER
JOYSTICK D-PAD
JOYSTICK BUTTON
ESP32-C3
