tedtoal/SmartVent_Thermostat/programs/SmartVentThermostat/nonvolatileSettings.h

/*
  nonvolatileSettings.h - Define constants, structs, variables, and functions
  for managing SmartVent thermostat non-volatile settings, which are stored in
  the Nano 33 IoT flash memory.
  Created by Ted Toal, 17-Aug-2023
  Released into the public domain.


  Software License Agreement (BSD License)

  Copyright (c) 2023 Ted Toal
  All rights reserved.

  Redistribution and use in source and binary forms, with or without
  modification, are permitted provided that the following conditions are met:
  1. Redistributions of source code must retain the above copyright
  notice, this list of conditions and the following disclaimer.
  2. Redistributions in binary form must reproduce the above copyright
  notice, this list of conditions and the following disclaimer in the
  documentation and/or other materials provided with the distribution.
  3. Neither the name of the copyright holders nor the
  names of its contributors may be used to endorse or promote products
  derived from this software without specific prior written permission.

  THIS SOFTWARE IS PROVIDED BY THE COPYRIGHT HOLDERS ''AS IS'' AND ANY
  EXPRESS OR IMPLIED WARRANTIES, INCLUDING, BUT NOT LIMITED TO, THE IMPLIED
  WARRANTIES OF MERCHANTABILITY AND FITNESS FOR A PARTICULAR PURPOSE ARE
  DISCLAIMED. IN NO EVENT SHALL THE COPYRIGHT HOLDER BE LIABLE FOR ANY
  DIRECT, INDIRECT, INCIDENTAL, SPECIAL, EXEMPLARY, OR CONSEQUENTIAL DAMAGES
  (INCLUDING, BUT NOT LIMITED TO, PROCUREMENT OF SUBSTITUTE GOODS OR SERVICES;
  LOSS OF USE, DATA, OR PROFITS; OR BUSINESS INTERRUPTION) HOWEVER CAUSED AND
  ON ANY THEORY OF LIABILITY, WHETHER IN CONTRACT, STRICT LIABILITY, OR TORT
  (INCLUDING NEGLIGENCE OR OTHERWISE) ARISING IN ANY WAY OUT OF THE USE OF THIS
*/
#ifndef nonvolatileSettings_h
#define nonvolatileSettings_h

#include <Arduino.h>

/////////////////////////////////////////////////////////////////////////////////////////////
// Constants.
/////////////////////////////////////////////////////////////////////////////////////////////

// Minimum and maximum temperature setpoints in degrees F.
#define MIN_TEMP_SETPOINT 50
#define MAX_TEMP_SETPOINT 99

// Minimum and maximum SmartVent-On indoor/outdoor temperature differential in degrees F.
#define MIN_TEMP_DIFFERENTIAL 2
#define MAX_TEMP_DIFFERENTIAL 20

// Minimum and maximum SmartVent-off temperature hysteresis in degrees F.
// The hysteresis is subtracted from the indoor setpoint to get the setpoint used to
// decide when to turn SmartVent off, and added to it to decide when to turn it on.
// It is added to the indoor/outdoor differential to get the value used to decide
// when to turn SmartVent on, and subtracted from it to decide when to turn it off.
#define MIN_TEMP_HYSTERESIS 1
#define MAX_TEMP_HYSTERESIS 9

// Maximum SmartVent run time limit in hours.
#define MAX_RUN_TIME_IN_HOURS 9

// String to show on LCD when max run time is 0.
#define MAX_RUN_TIME_0 "--"

// Maximum SmartVent delta arm temperature in degrees F. After SmartVent runs for the
// maximum run time, it is turned off and disarmed from turning on again UNTIL the
// outdoor temperature exceeds the indoor temperature by the delta arm temperature.
// This ensures that SmartVent runs only once per day for the specified maximum run
// time limit.
#define MAX_DELTA_ARM_TEMP 20

// Maximum temperature calibration adjustment in degrees F. Minimum is negative of this.
#define MAX_TEMP_CALIB_DELTA 9

/////////////////////////////////////////////////////////////////////////////////////////////
// Structs and enums.
/////////////////////////////////////////////////////////////////////////////////////////////

// SmartVent mode.
typedef enum _eSmartVentMode {
  MODE_OFF,
  MODE_ON,
  MODE_AUTO
} eSmartVentMode;

// Structure containing non-volatile data to be stored in flash memory (with copy in regular memory).
struct nonvolatileSettings {
  eSmartVentMode SmartVentMode; // SmartVent mode
  uint8_t TempSetpointOn;       // Indoor temperature setpoint in °F for SmartVent to turn on.
  uint8_t DeltaTempForOn;       // Indoor temperature must exceed outdoor by this to turn on SmartVent.
  uint8_t Hysteresis;           // Hysteresis °F, +/- this around TempSetpointOn and DeltaTempForOn to turn on/off.
  uint8_t MaxRunTimeHours;      // Run time limit in hours (AUTO or ON mode, AUTO is cumulative), 0 = none
  uint8_t DeltaNewDayTemp;      // Outdoor temperature must exceed indoor by this to start a new day (run timer is cleared).
  // Note: Following two values are NOT incorporated into temperatures read by temperature.h/.cpp.
  // Instead, they are only used to adjust curIndoorTemperature and curOutdoorTemperature before they are used in
  // SmartVentThermostat.ino.
  int8_t IndoorOffsetF;         // Amount to add to measured indoor temperature in °F to get temperature to display.
  int8_t OutdoorOffsetF;        // Amount to add to measured outdoor temperature in °F to get temperature to display.
  int16_t TS_LR_X;              // Touchscreen calibration parameter 1.
  int16_t TS_LR_Y;              // Touchscreen calibration parameter 2.
  int16_t TS_UL_X;              // Touchscreen calibration parameter 3.
  int16_t TS_UL_Y;              // Touchscreen calibration parameter 4.
};

/////////////////////////////////////////////////////////////////////////////////////////////
// Variables.
/////////////////////////////////////////////////////////////////////////////////////////////

// The currently active settings (initialized from flash-based EEPROM and stored in EEPROM
// each time the data changes via copy from userSettings).
extern nonvolatileSettings activeSettings;

// The current settings seen by the user, held here until
// USER_ACTIVITY_DELAY_SECONDS has elapsed with no screen touches,
// at which time this is copied to "activeSettings" and the latter
// is then stored in EEPROM.
extern nonvolatileSettings userSettings;

// The default settings, used to initialize empty flash-based EEPROM.
// Touchscreen calibration parameters are 0 and must be set by caller.
extern nonvolatileSettings settingDefaults;

/////////////////////////////////////////////////////////////////////////////////////////////
// Functions.
/////////////////////////////////////////////////////////////////////////////////////////////

/////////////////////////////////////////////////////////////////////////////////////////////
// Read non-volatile settings from flash memory into settings.  If flash memory has not yet
// been initialized, initialize it with defaults.
/////////////////////////////////////////////////////////////////////////////////////////////
extern void readNonvolatileSettings(nonvolatileSettings& settings,
  const nonvolatileSettings& defaults);

/////////////////////////////////////////////////////////////////////////////////////////////
// Write non-volatile settings to flash memory IF IT HAS CHANGED. Return true if it changed
// and was written, else false.
/////////////////////////////////////////////////////////////////////////////////////////////
extern boolean writeNonvolatileSettingsIfChanged(nonvolatileSettings& settings);

#endif // nonvolatileSettings_h
