tedtoal/SmartVent_Thermostat/(commit log)

2023-08-23 Add more files and documents, make thermistor folder
    [SmartVent Thermostat Schematic V4.kicad_pcb, SmartVent Thermostat Schematic V4.kicad_sch, SmartVentPrototypeArea.xlsx]
2023-08-24 Add some datasheets
    [SmartVentPrototypeArea.xlsx]
2023-09-08 Update with recent changes before initial release of thermostat project on hackster.io
    [SmartVentPrototypeArea.xlsx]
2023-09-11 Updates during proofreading
    [AZ-Touch_MKR_Nano_SAMD21G_pins.xlsx, SmartVent Thermostat Schematic V4.kicad_sch]
